BraianCaballero/Medidor-Aire-Nuevo-WIFI/esquematico nodemcu v1-Model.pdf

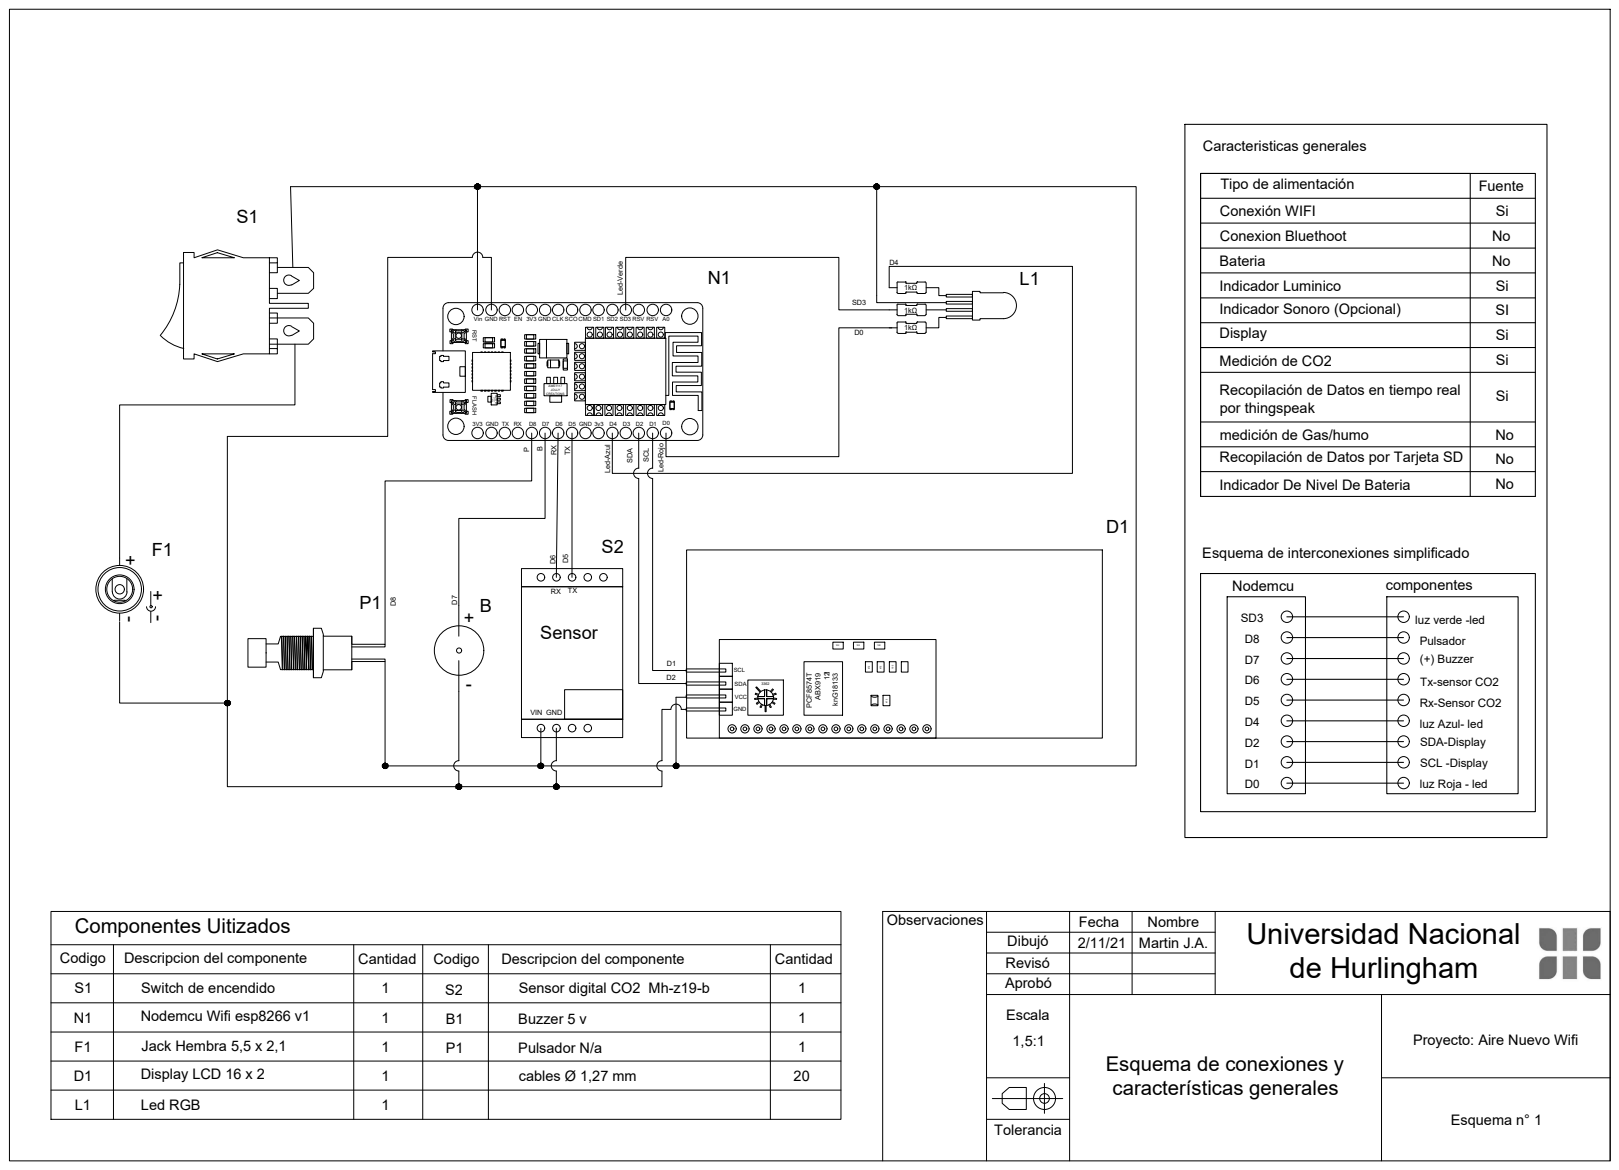
[picture p2: page 1]

Tipo de alimentación | Fuente
Conexión WIFI | Si
Conexion Bluethoot | No
Bateria | No
Indicador Luminico | Si
Indicador Sonoro (Opcional) | SI
Display | Si

Vin GND RST EN 3V3 GND CLK SCO CMD SD1 SD2 SD3 RSV RSV A0 FLASH RST

JOLLY CREATIONS AMS1117 JOLLY CREATIONS

Recopilación de Datos en tiempo real por thingspeak | Si

medición de Gas/humo | No
Recopilación de Datos por Tarjeta SD | No

Indicador De Nivel De Bateria | No

Esquema de interconexiones simplificado

Dibujó | 2/11/21 | Martin J.A.
Revisó

Codigo | Descripcion del componente | Cantidad | Codigo | Descripcion del componente | Cantidad

N1 | Nodemcu Wifi esp8266 v1 | 1 | B1 | Buzzer 5 v | 1

F1 | Jack Hembra 5,5 x 2,1 | 1 | P1 | Pulsador N/a | 1

Proyecto: Aire Nuevo Wifi

D1 | Display LCD 16 x 2 | 1 | | cables Ø 1,27 mm | 20

L1 | Led RGB | 1
